GBldN/WATER_ROCKET/README.md

# FUSEE A EAU
<p align="center">
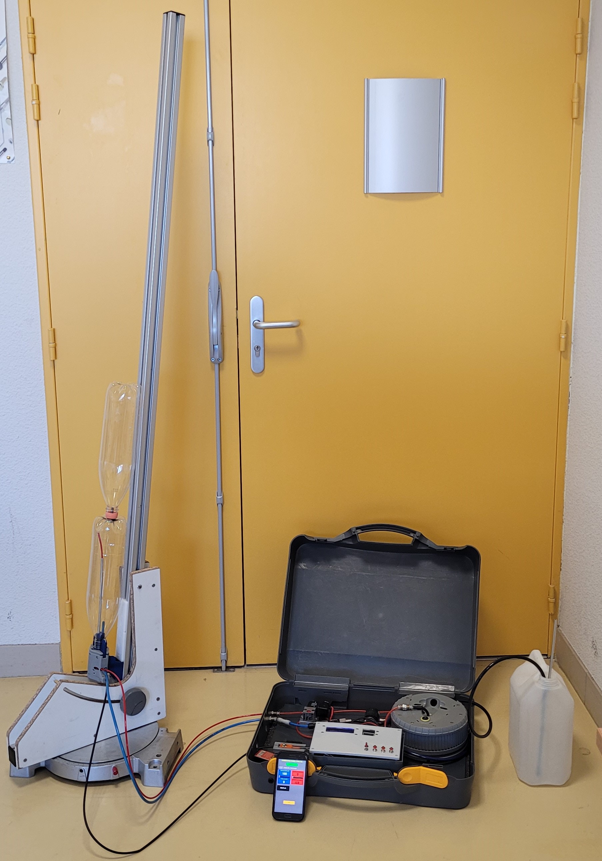
[picture p1: Mise en situation.jpg]
Illustration


### 1- PROJET
Dans le cadre de la spécialité sciences de l’ingénieur, le projet consiste à suivre les différentes étapes d’ingénierie nécessaires pour la conception d’une fusée à propulsion à eau et air comprimé et de sa base de lancement optimisées afin de répondre à un cahier des charges précis.

### 2- LE CAHIER DES CHARGES
Concevoir une fusée à propulsion à eau similaire aux fusées qui participent au concours [ROCKETRY CHALLENGE](https://www.planete-sciences.org/espace/Rocketry-Challenge/Presentation) organisé par planette science.
  
Dans ce concours, il s'agit de propulser un œuf de poule cru d’une masse comprise entre 55 et 61 grammes et d’un diamètre de 45 mm maximum (orientation libre). 
  
L’œuf doit revenir du vol sans aucune fissure ni dommage externe.
  
Les principaux éléments du règlement et du cahier des charges sont reproduits (et parfois simplifiés) dans le [cahier des charges fonctionnel](FUSEE%20A%20EAU_CDCF%20PROJET.pdf)

### 3 - LES SIMULATIONS :

- Calcul du CX à partir d'une simulation aérodynamique

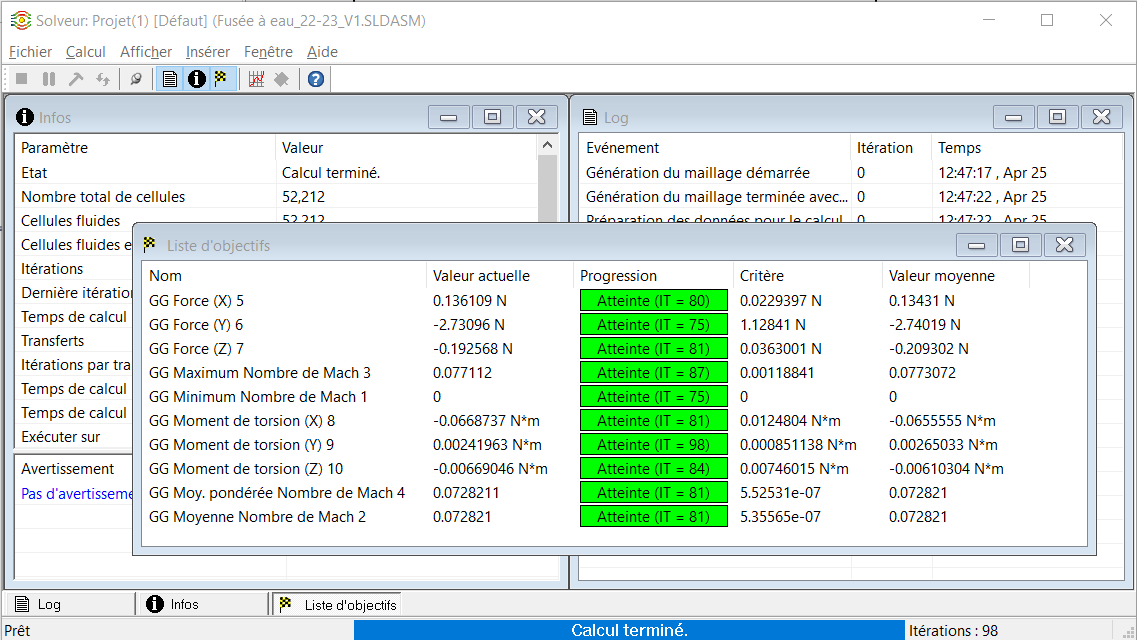
[picture p2: simulation fusée V1 25 m.s-1.png]
Simulation aerodynamique
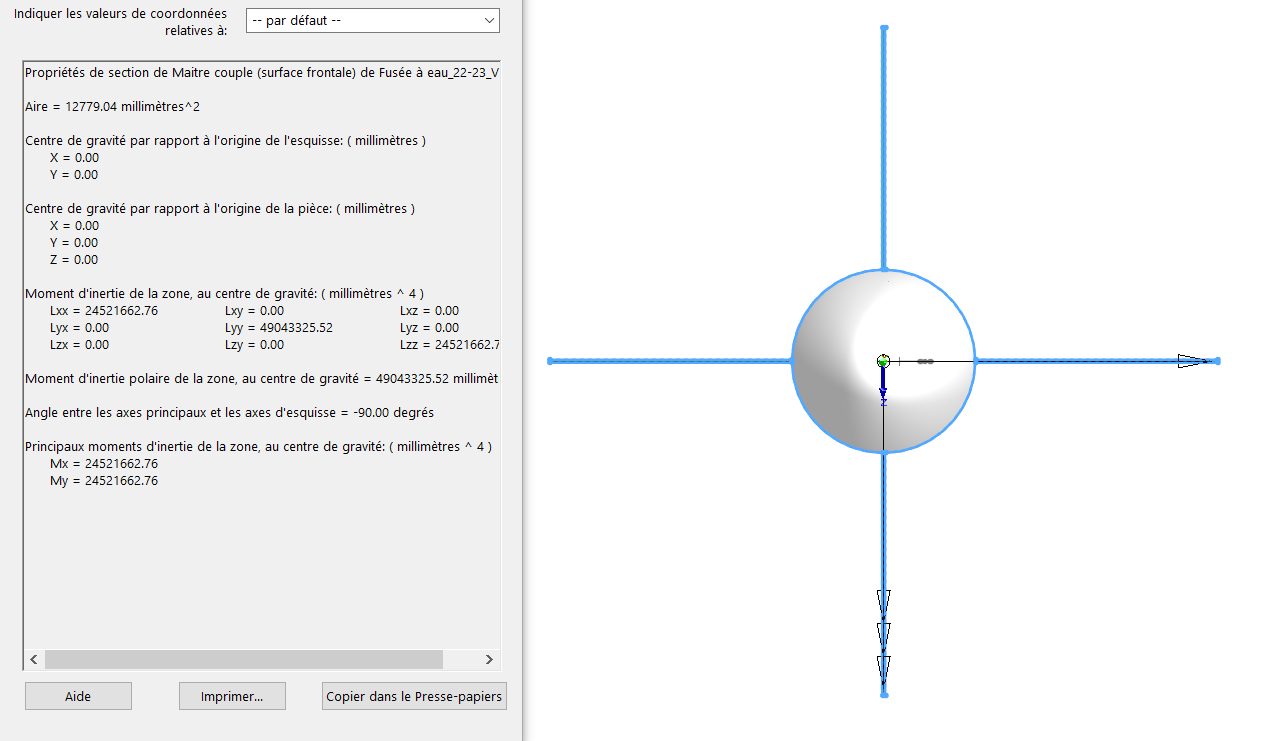
[picture p3: Maitre couple (surface frontale).png]
maitre couple
   

- Calcul de l'apogée théorique à partir de simulation Mécanique

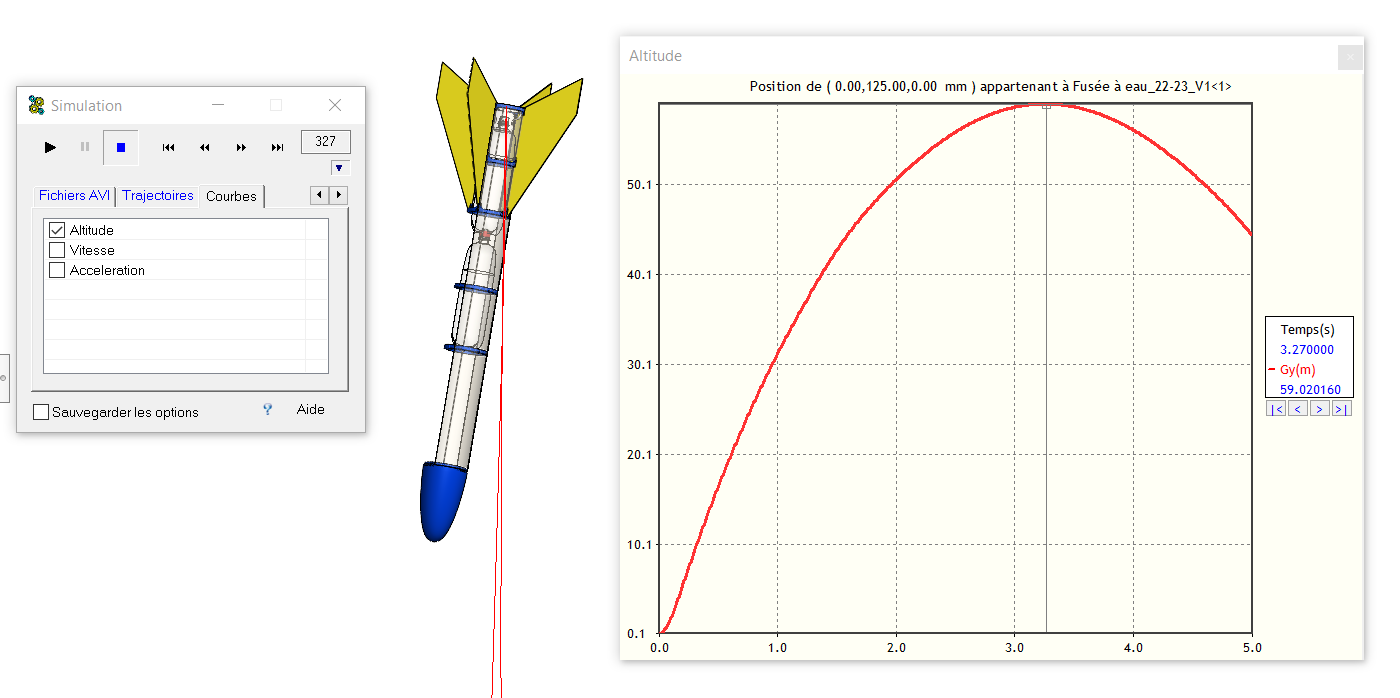
[picture p4: Simulation MECA3D Apogée.png]
Simulation mécanique
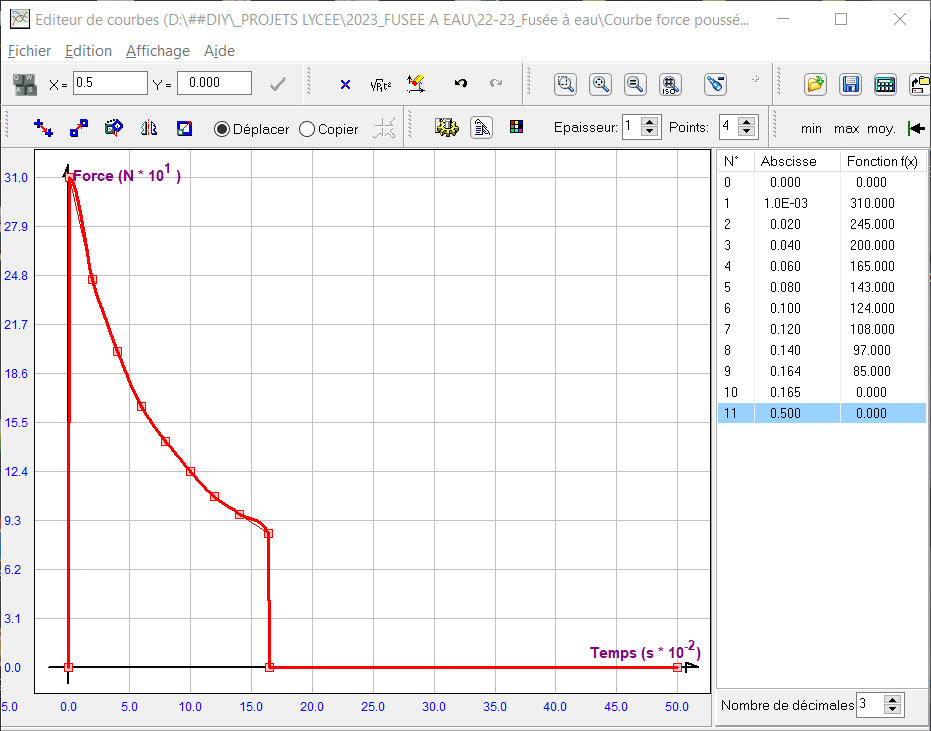
[picture p5: Courbe Force poussée.png]
Courbe poussée
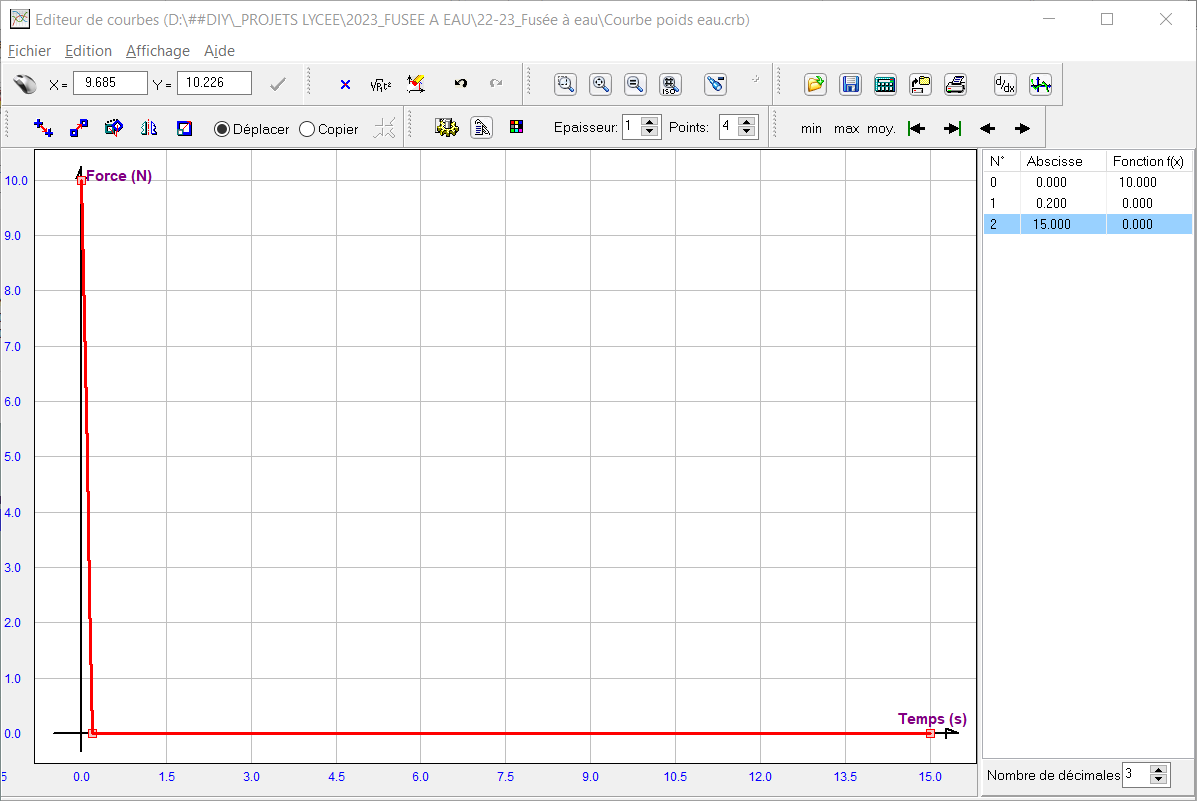
[picture p6: Courbe poids eau.png]
Courbe poid eau
  

 [Vidéo de la simulation](https://youtu.be/bQ_ySXu53Rc)

### 4 - MATERIEL :
Le système est décomposé en plusieurs sous ensembles :
- La RAMPE de lancement

- Le système de LARGAGE

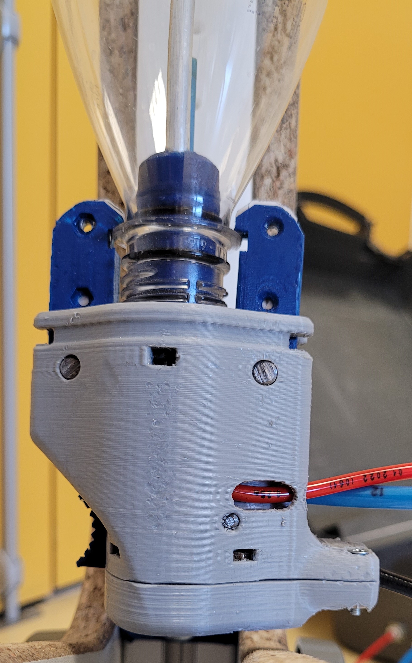
[picture p7: Lanceur fermé.jpg]
FERME
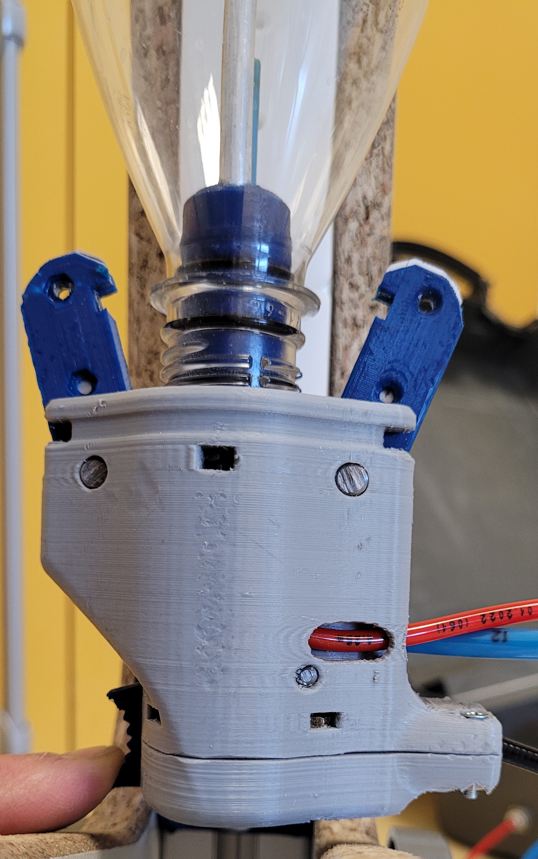
[picture p8: Lanceur ouvert.jpg]
OUVERT
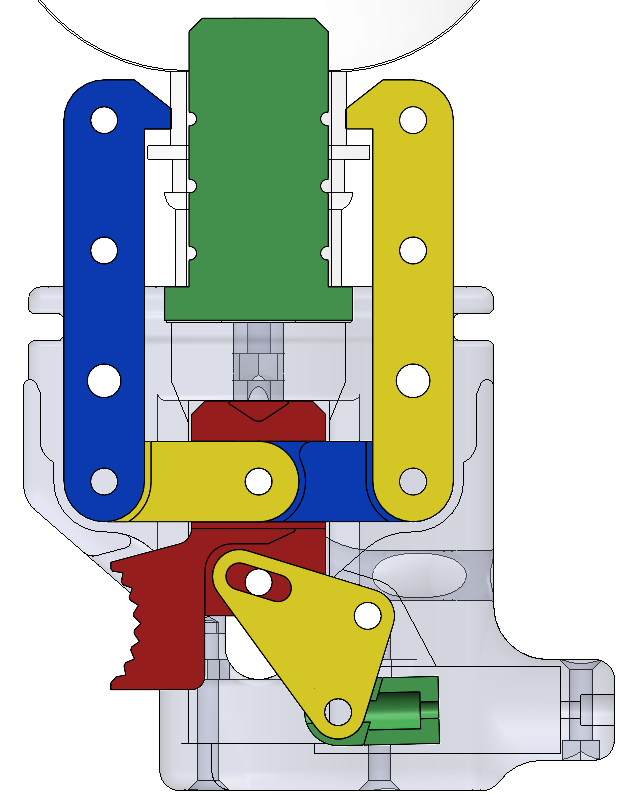
[picture p9: Largage fermé.png]
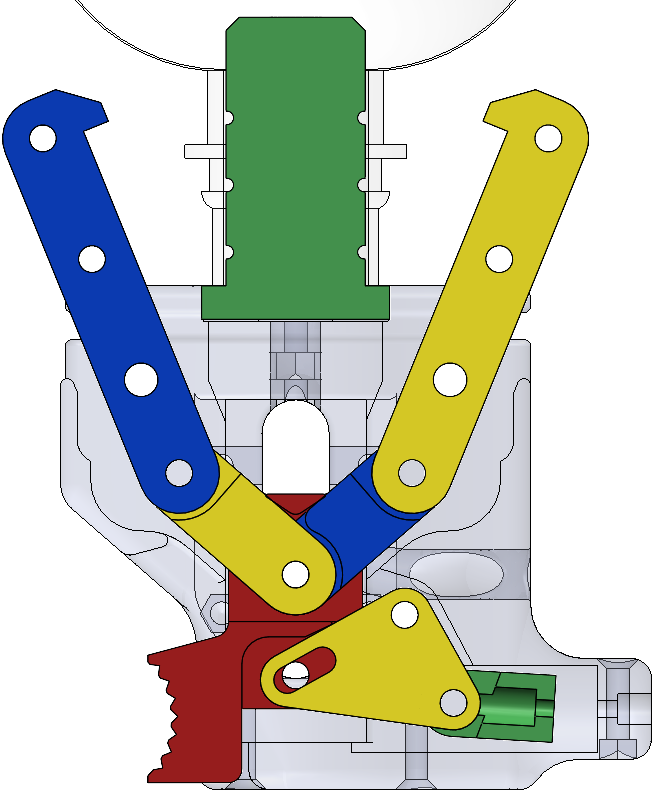
[picture p10: Largage ouvert.png]
OUVERT
   

- La VALISE d'automatisation

    Elle est controlée par une carte à microcontroleur Arduino MEGA [programme ARDUINO pour carte MEGA](Fusee_a_eau_Commande_BT_MEGA.ino)
  
    Les différentes consignes de commande peuvent se faire en mode manuel avec 4 boutons poussoirs mais aussi en Bluetooth grâce à une application ANDROID programmé avec [APP INVENTOR](https://gallery.appinventor.mit.edu/?galleryid=ee9647f1-101d-46b4-a1c1-f9438da695b3)

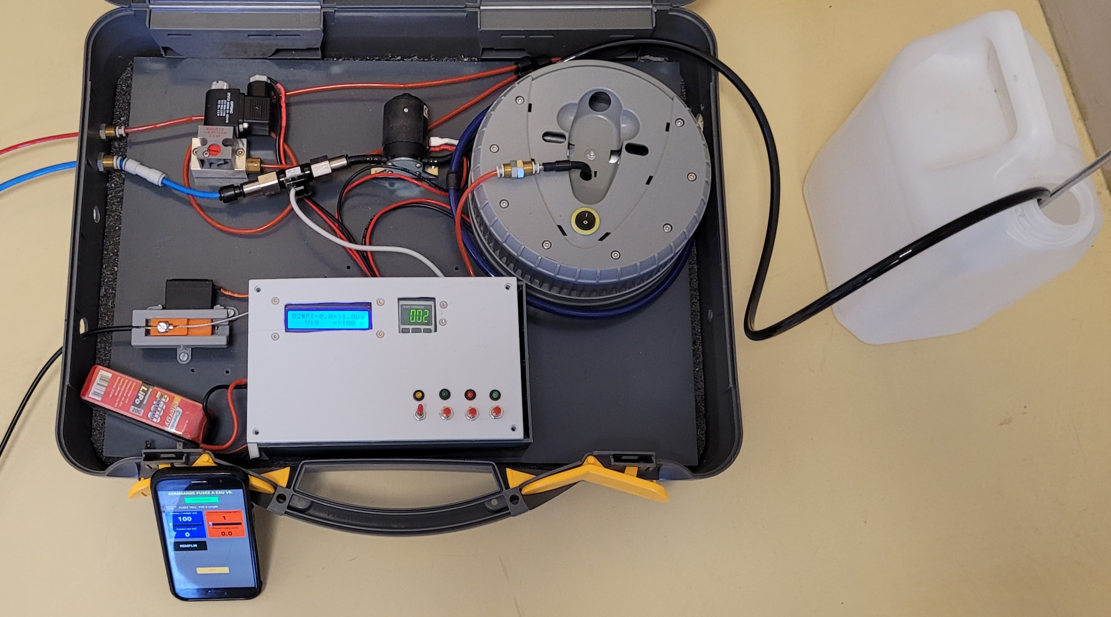
[picture p11: Valise.jpg]
VALISE


- la fusée à eau (en cours de fabrication)

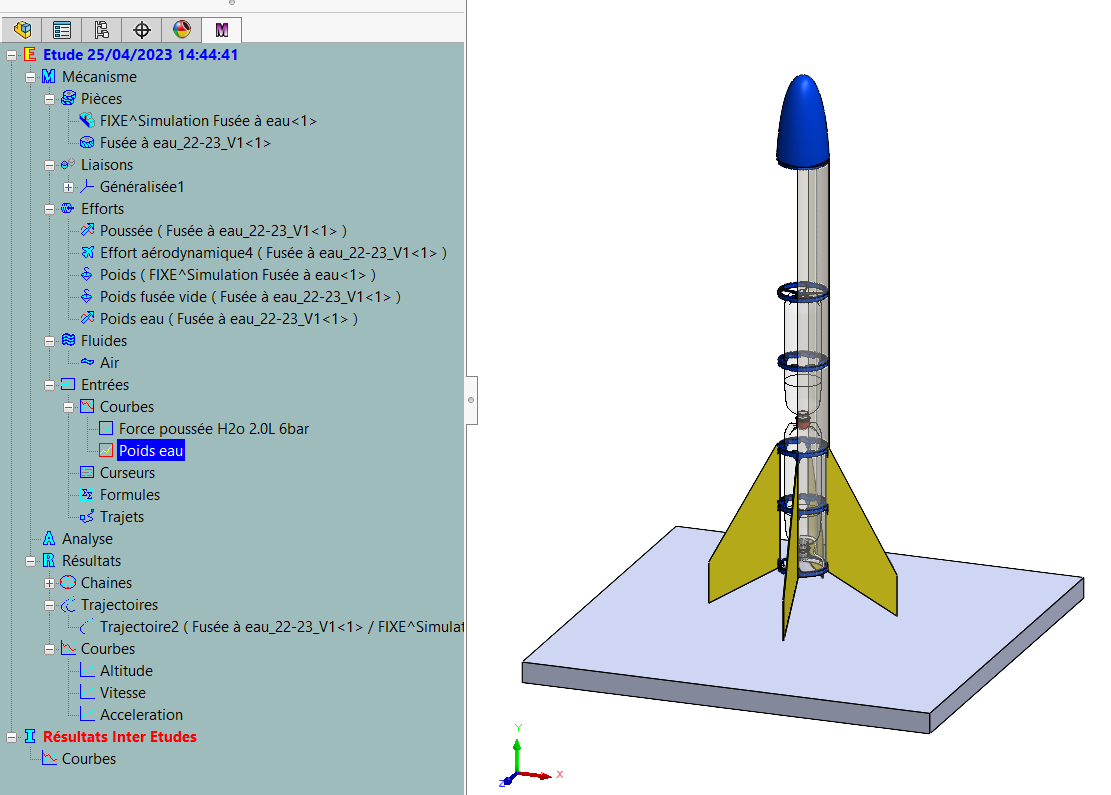
[picture p12: Fusée à eau MECA3D.png]
Simulation mécanique de la FUSEE
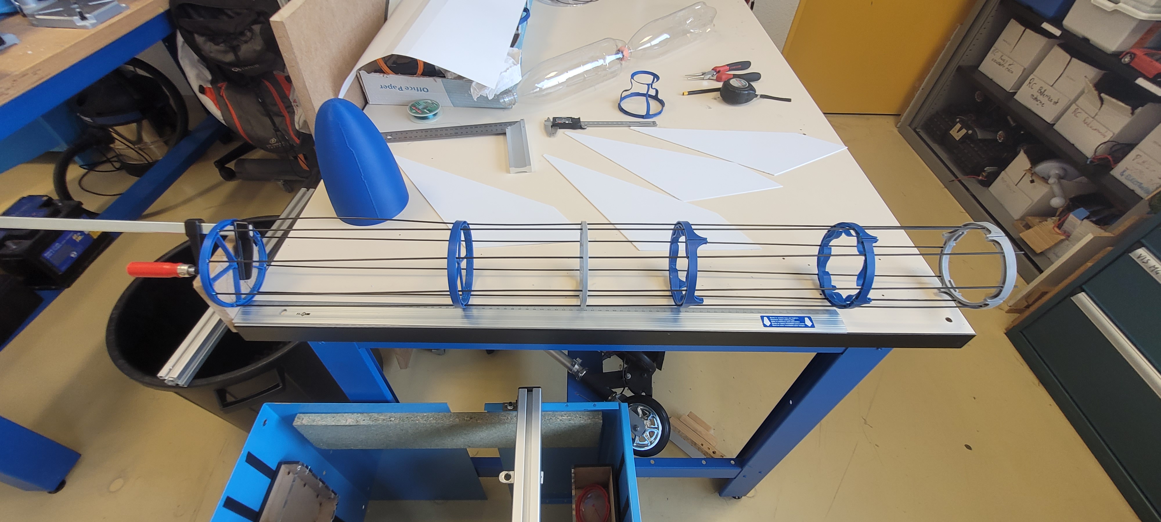
[picture p13: Montage.jpg]
Montage de la FUSEE
 

### 5 - LES TESTS :
- Banc de TEST DE RESISTANCE à la pression
  
    Permet de vérifier la tenue à la pression des bouteilles de soda utilisées ( explosion à plus de 12 bars), mais aussi l'expension des dimensions de la fusée pendant la compression.
  
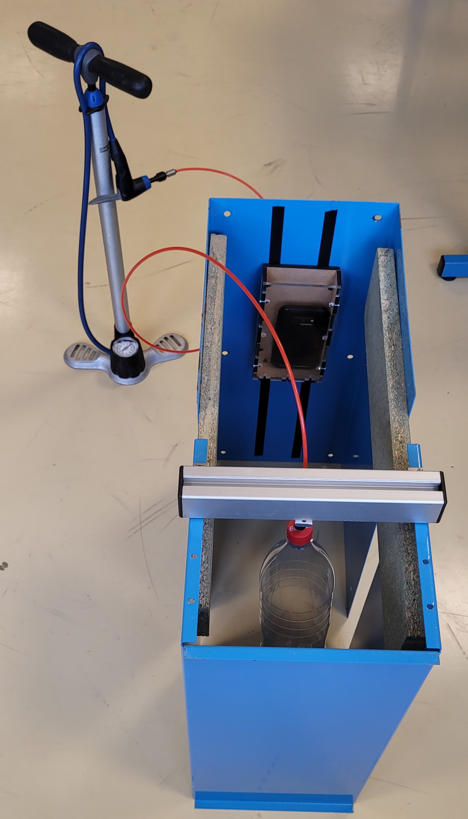
[picture p14: Banc test pression.jpg]
BANC TEST PRESSION
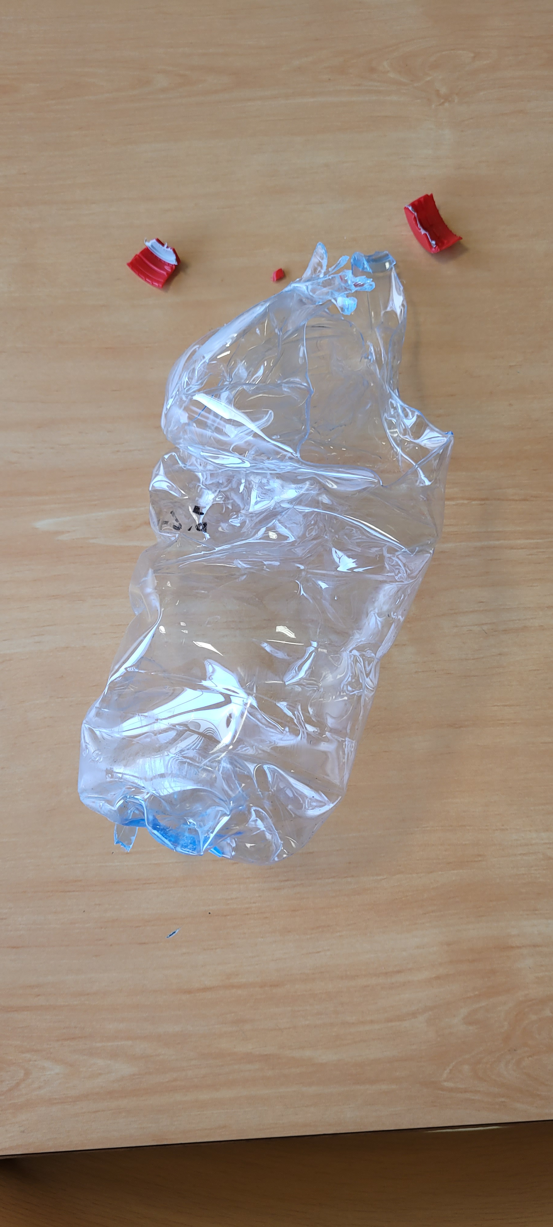
[picture p15: Bouteille explosée.jpg]
CRASH TEST
 

- Banc de TEST DE POUSSEE
  
    Il s'agit d'un banc équipé d'un capteur de FORCE permettant d'évaluer la courbe de poussée de l'étage de propulsion en fonction du volume d'eau et de la pression de l'air.
  
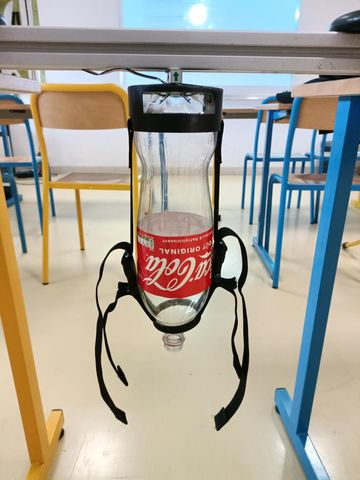
[picture p16: Banc test poussée.jpg]
BANC TEST POUSSEE
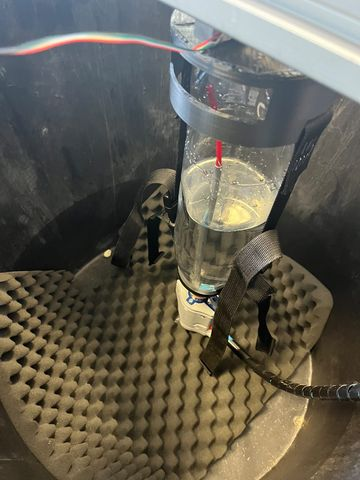
[picture p17: Banc test poussée2.jpg]
BANC TEST POUSSEE2
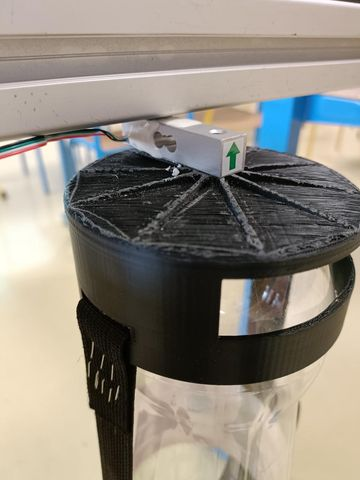
[picture p18: Banc test poussée capteur.jpg]
CAPTEUR DE FORCE
  

 [Vidéo test poussée](https://youtube.com/shorts/VaxSK4kgV1k)

-LES PREMIERS ESSAIS EN EXTERIEUR

  [Premier test](https://youtube.com/shorts/n9TUfji-JI4)
  
  [Largage au ralenti](https://youtube.com/shorts/VSt-5mvT0KY?feature=share)
