GBldN/WATER_ROCKET/fusée V1.png

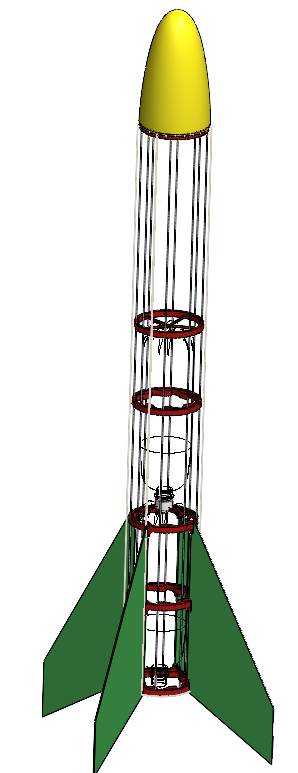
fusée V1.png
